Sudhan7535/IoT-Based-Water-Quality-Monitoring-System/Assets/Drum Setup.jpeg

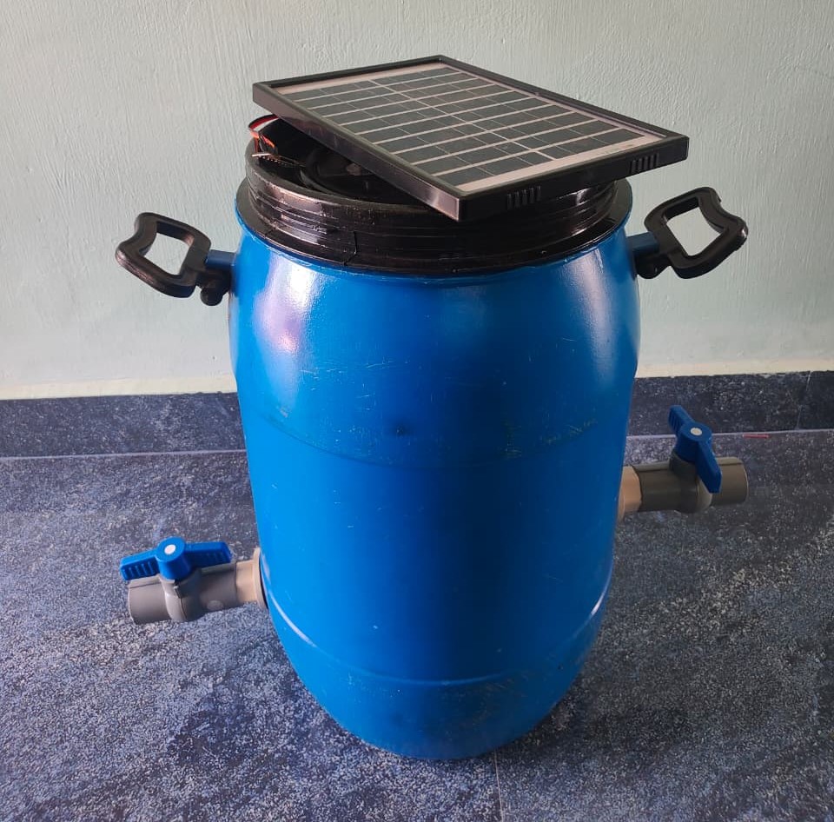
Assets/Drum Setup.jpeg
