Sudhan7535/IoT-Based-Water-Quality-Monitoring-System/Assets/Enclosure setup 2.jpg

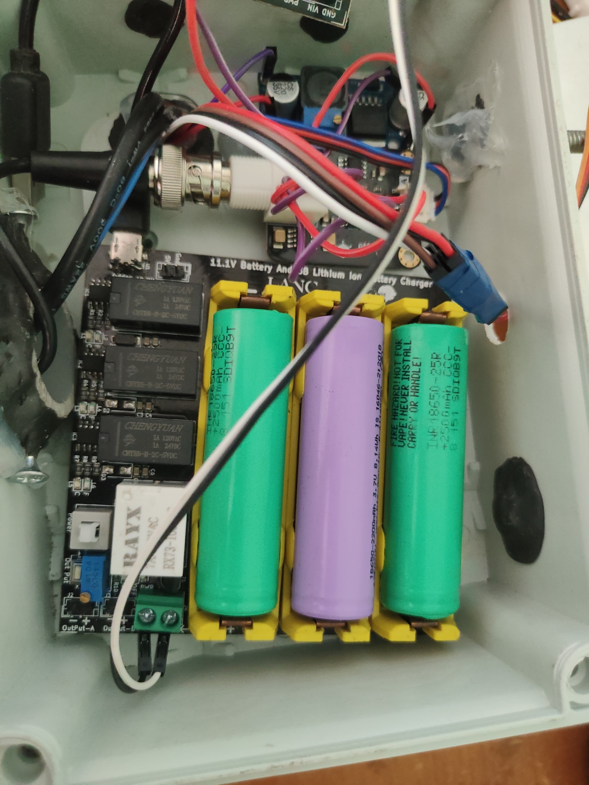
Assets/Enclosure setup 2.jpg
