Sudhan7535/IoT-Based-Water-Quality-Monitoring-System/Assets/Esp32-wroom-Developer-Module.png

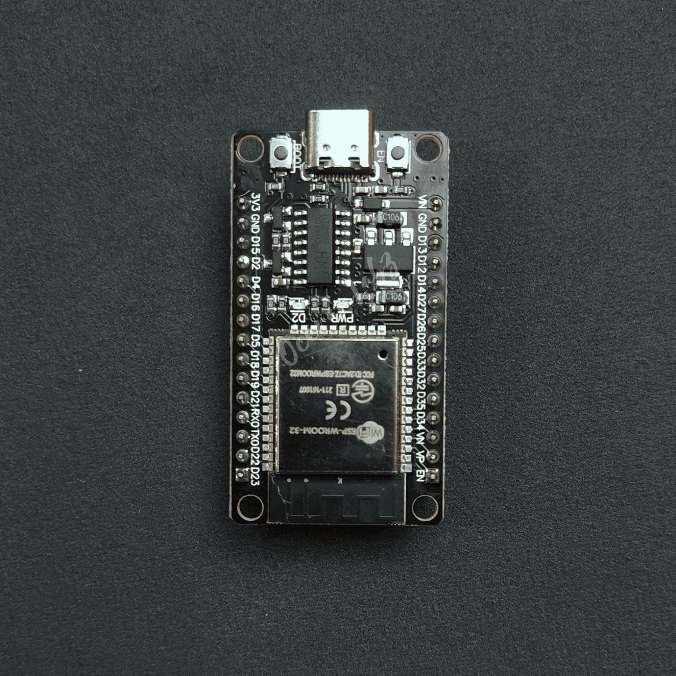
Assets/Esp32-wroom-Developer-Module.png
