Sudhan7535/IoT-Based-Water-Quality-Monitoring-System/Assets/Ph Sensor.png

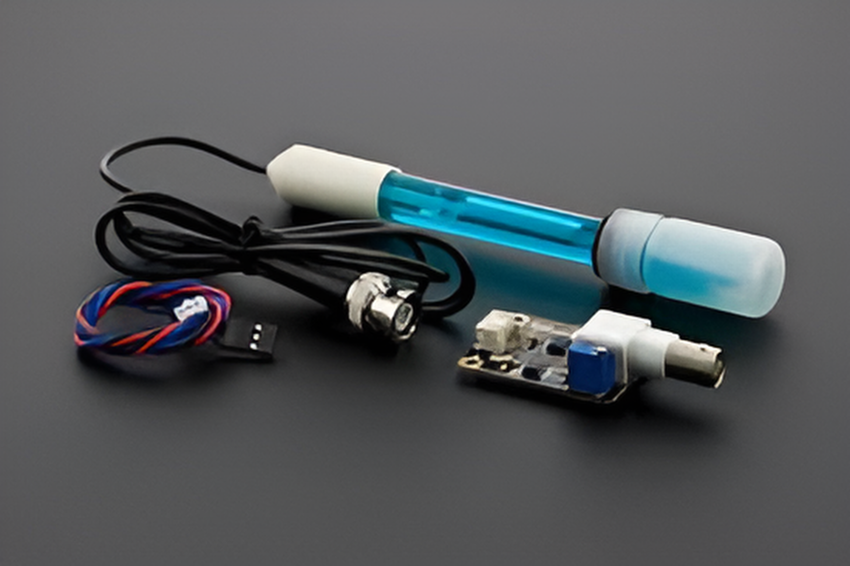
Assets/Ph Sensor.png
