Sudhan7535/IoT-Based-Water-Quality-Monitoring-System/Assets/ThingSpeak UI.png

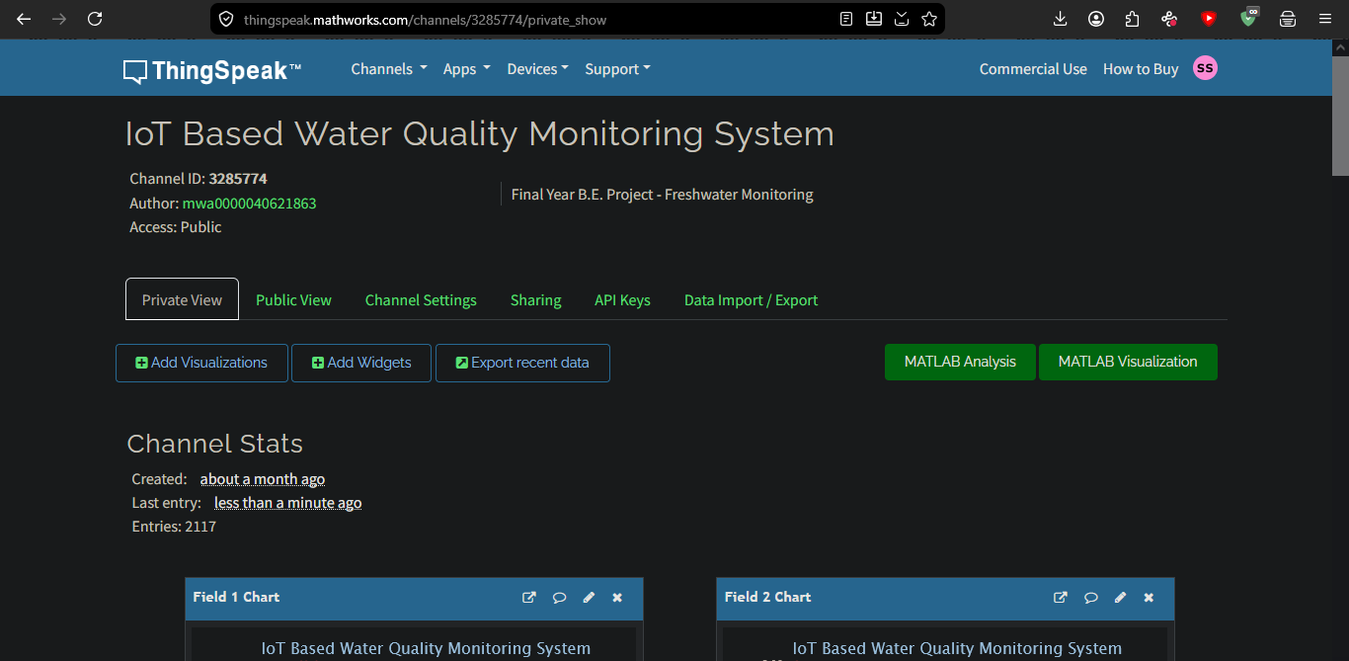
Assets/ThingSpeak UI.png
