Sudhan7535/IoT-Based-Water-Quality-Monitoring-System/Assets/Turbidity Sensor.png

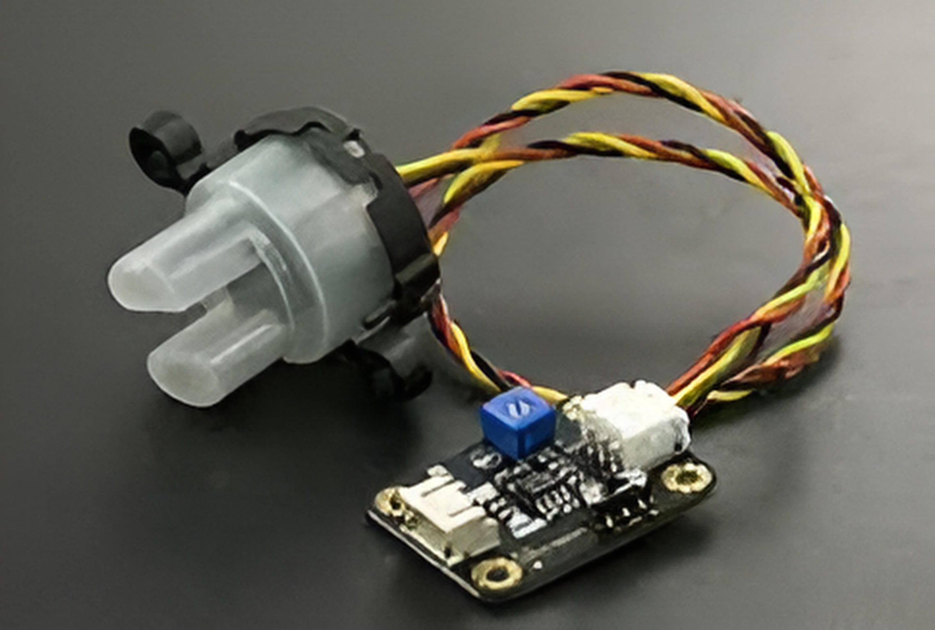
Assets/Turbidity Sensor.png
