Sudhan7535/IoT-Based-Water-Quality-Monitoring-System/Assets/LANC 5v 3A DC step down Power supply board.jpg

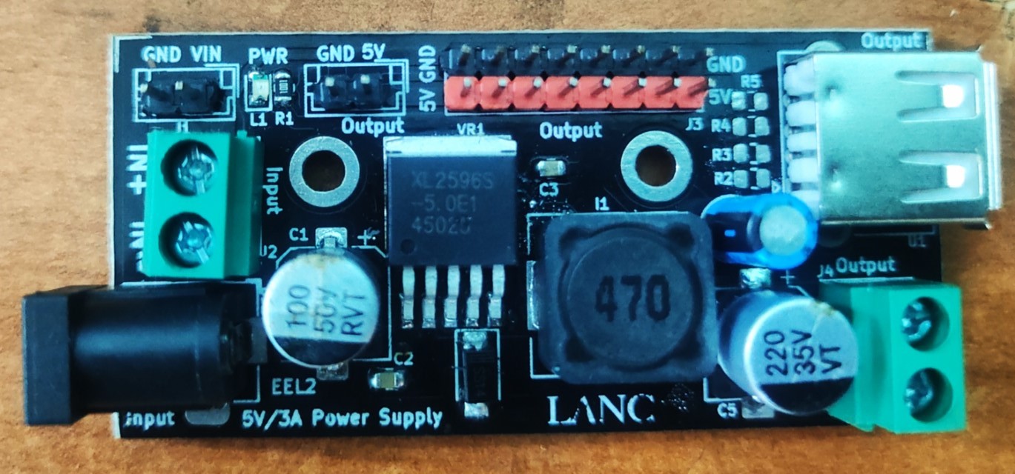
Assets/LANC 5v 3A DC step down Power supply board.jpg
