Sudhan7535/IoT-Based-Water-Quality-Monitoring-System/Assets/PVC Setup.jpeg

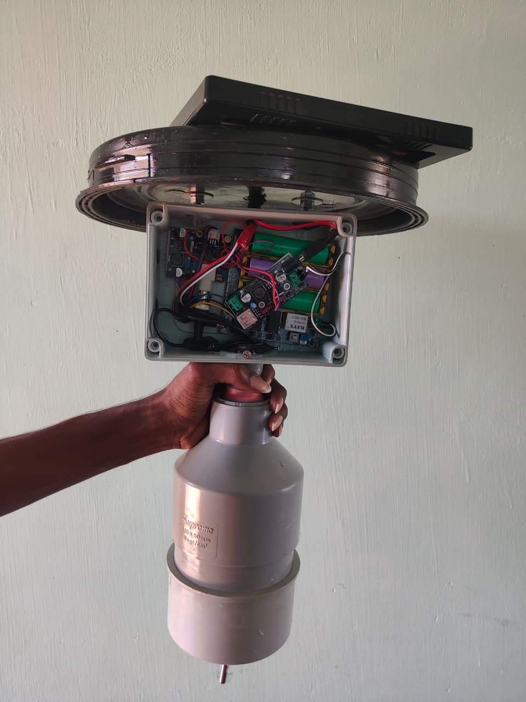
Assets/PVC Setup.jpeg
